RGBeter/MegaDrive_VA6.8/MegaDrive.kicad_pcb

## KiCad design MegaDrive.kicad_pcb (2026-10-28)

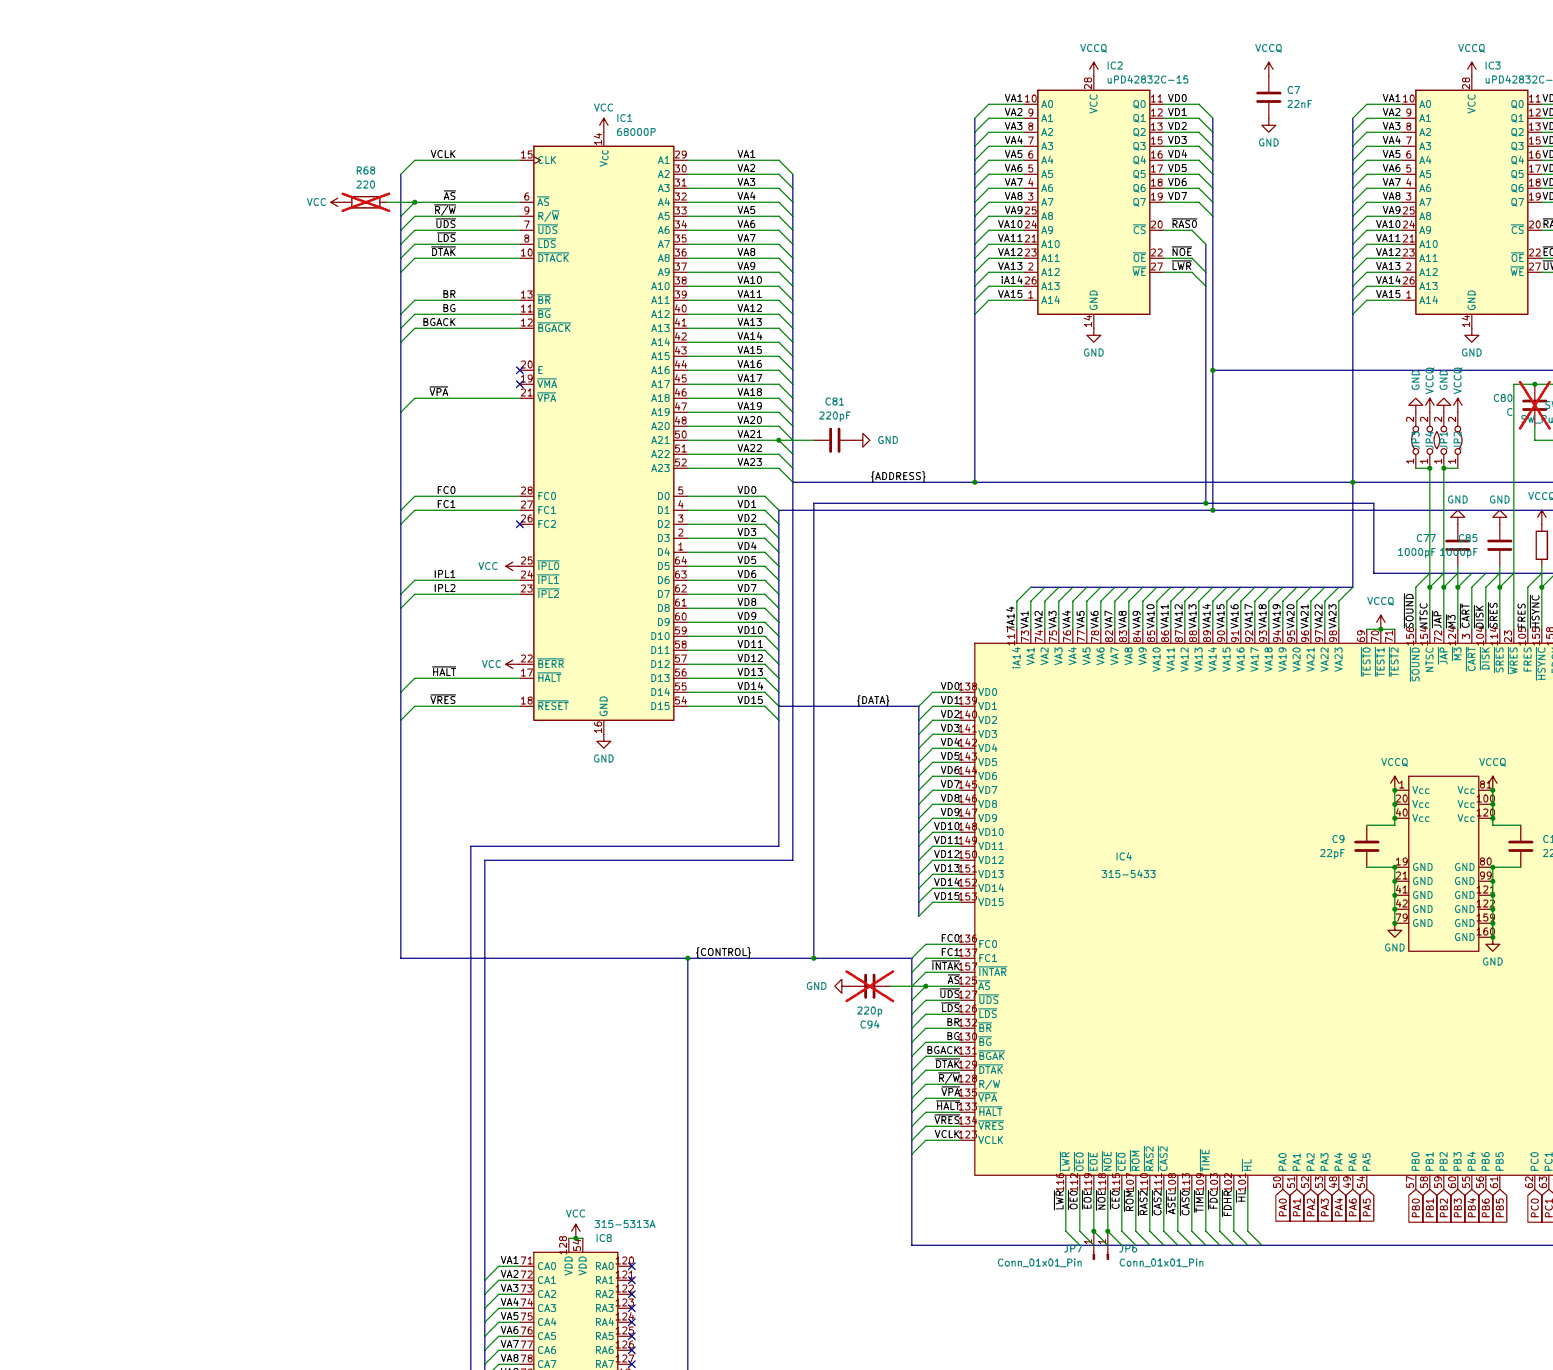
[picture p1: schematic MegaDrive.kicad_sch, part in row 1, column 1]

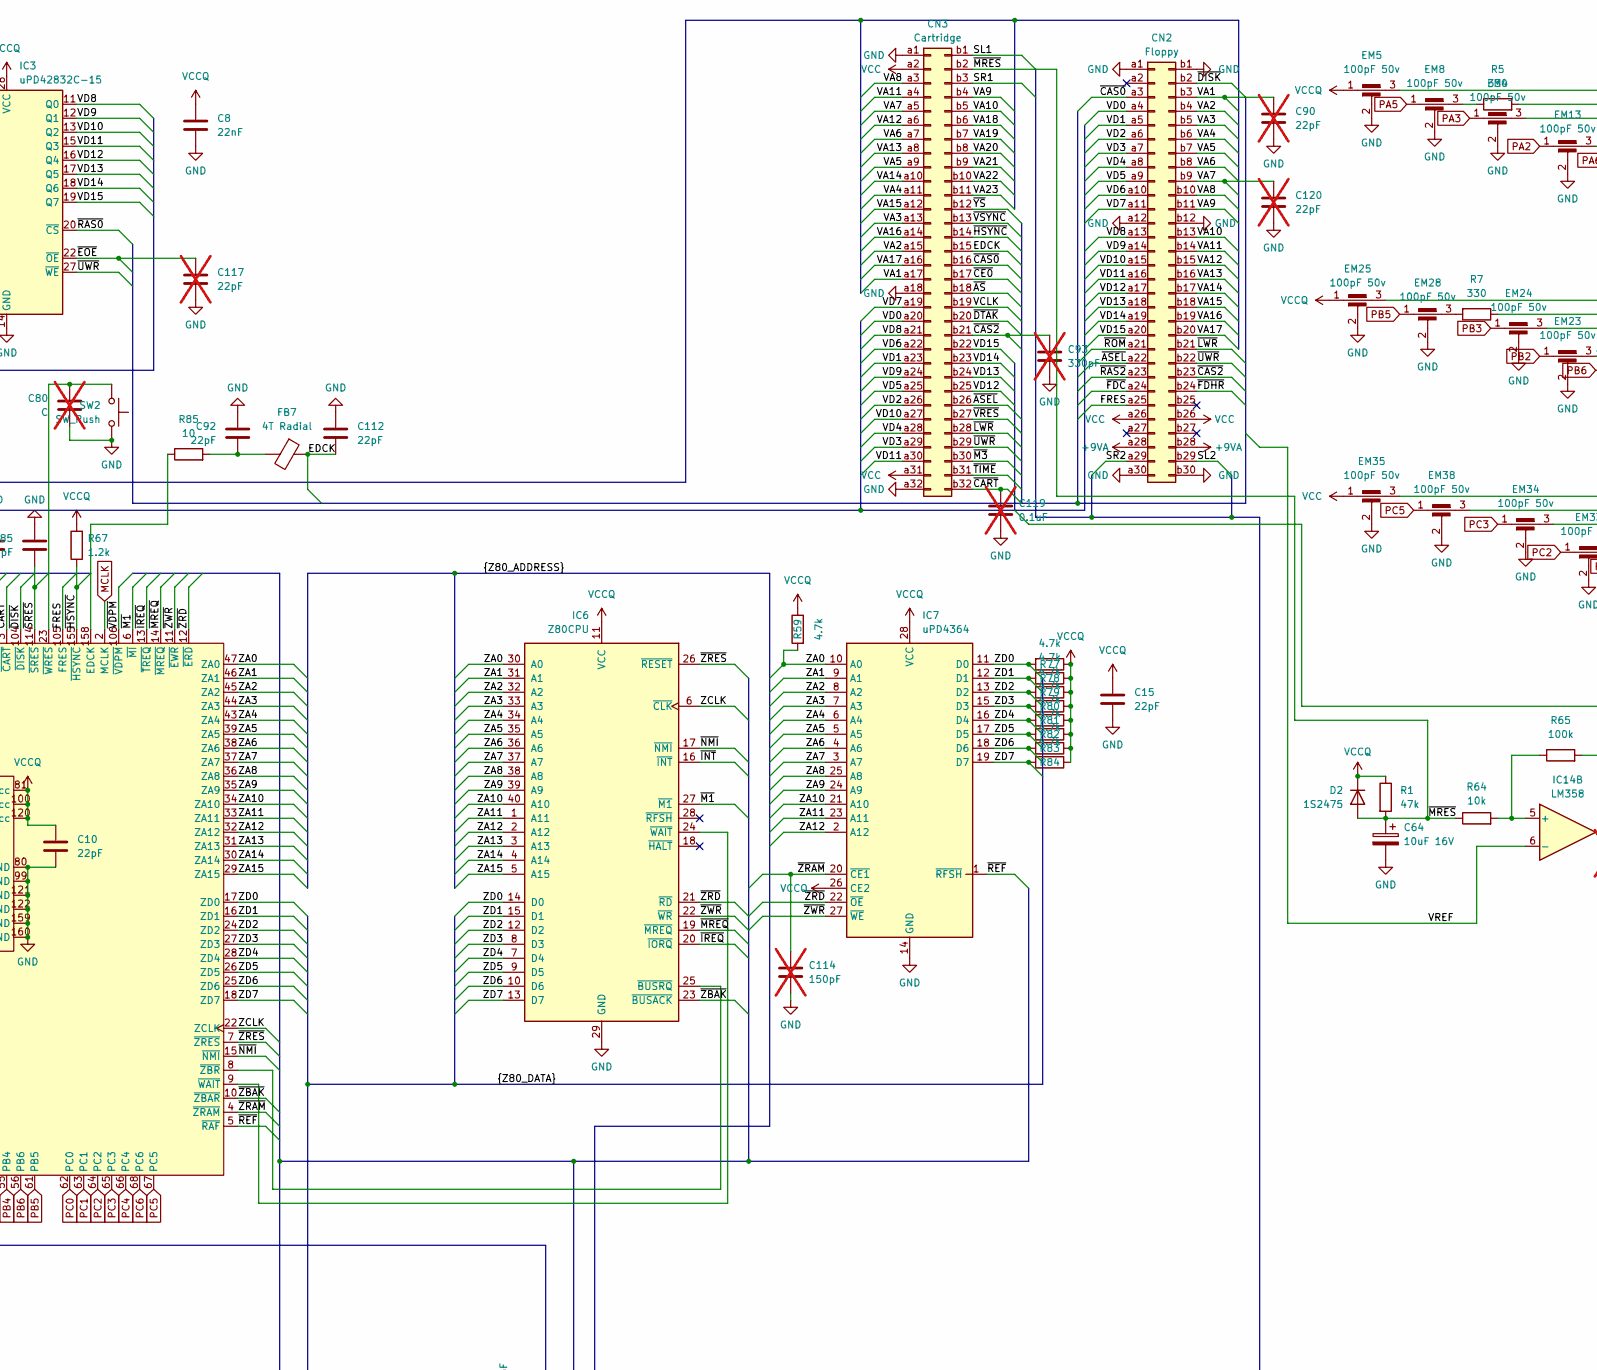
[picture p2: schematic MegaDrive.kicad_sch, part in row 1, column 2]

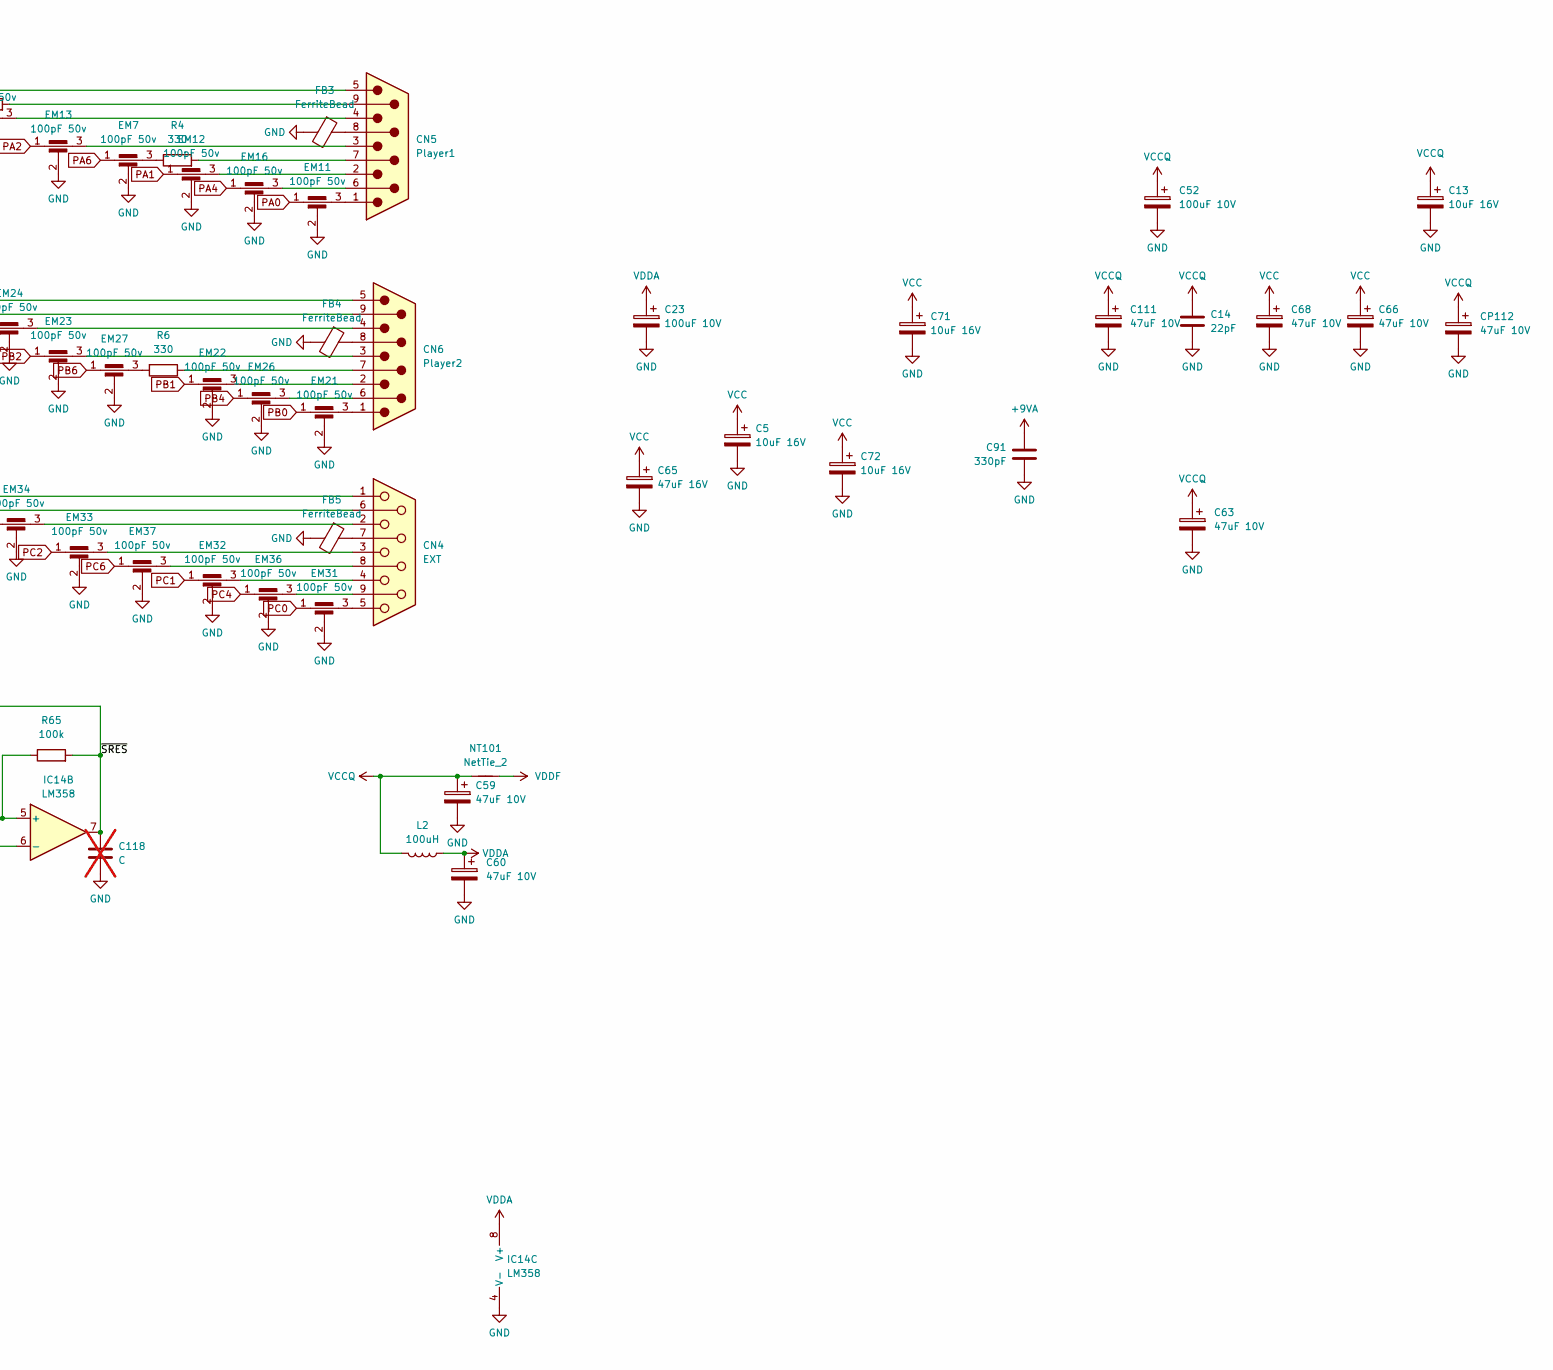
[picture p3: schematic MegaDrive.kicad_sch, part in row 1, column 3]

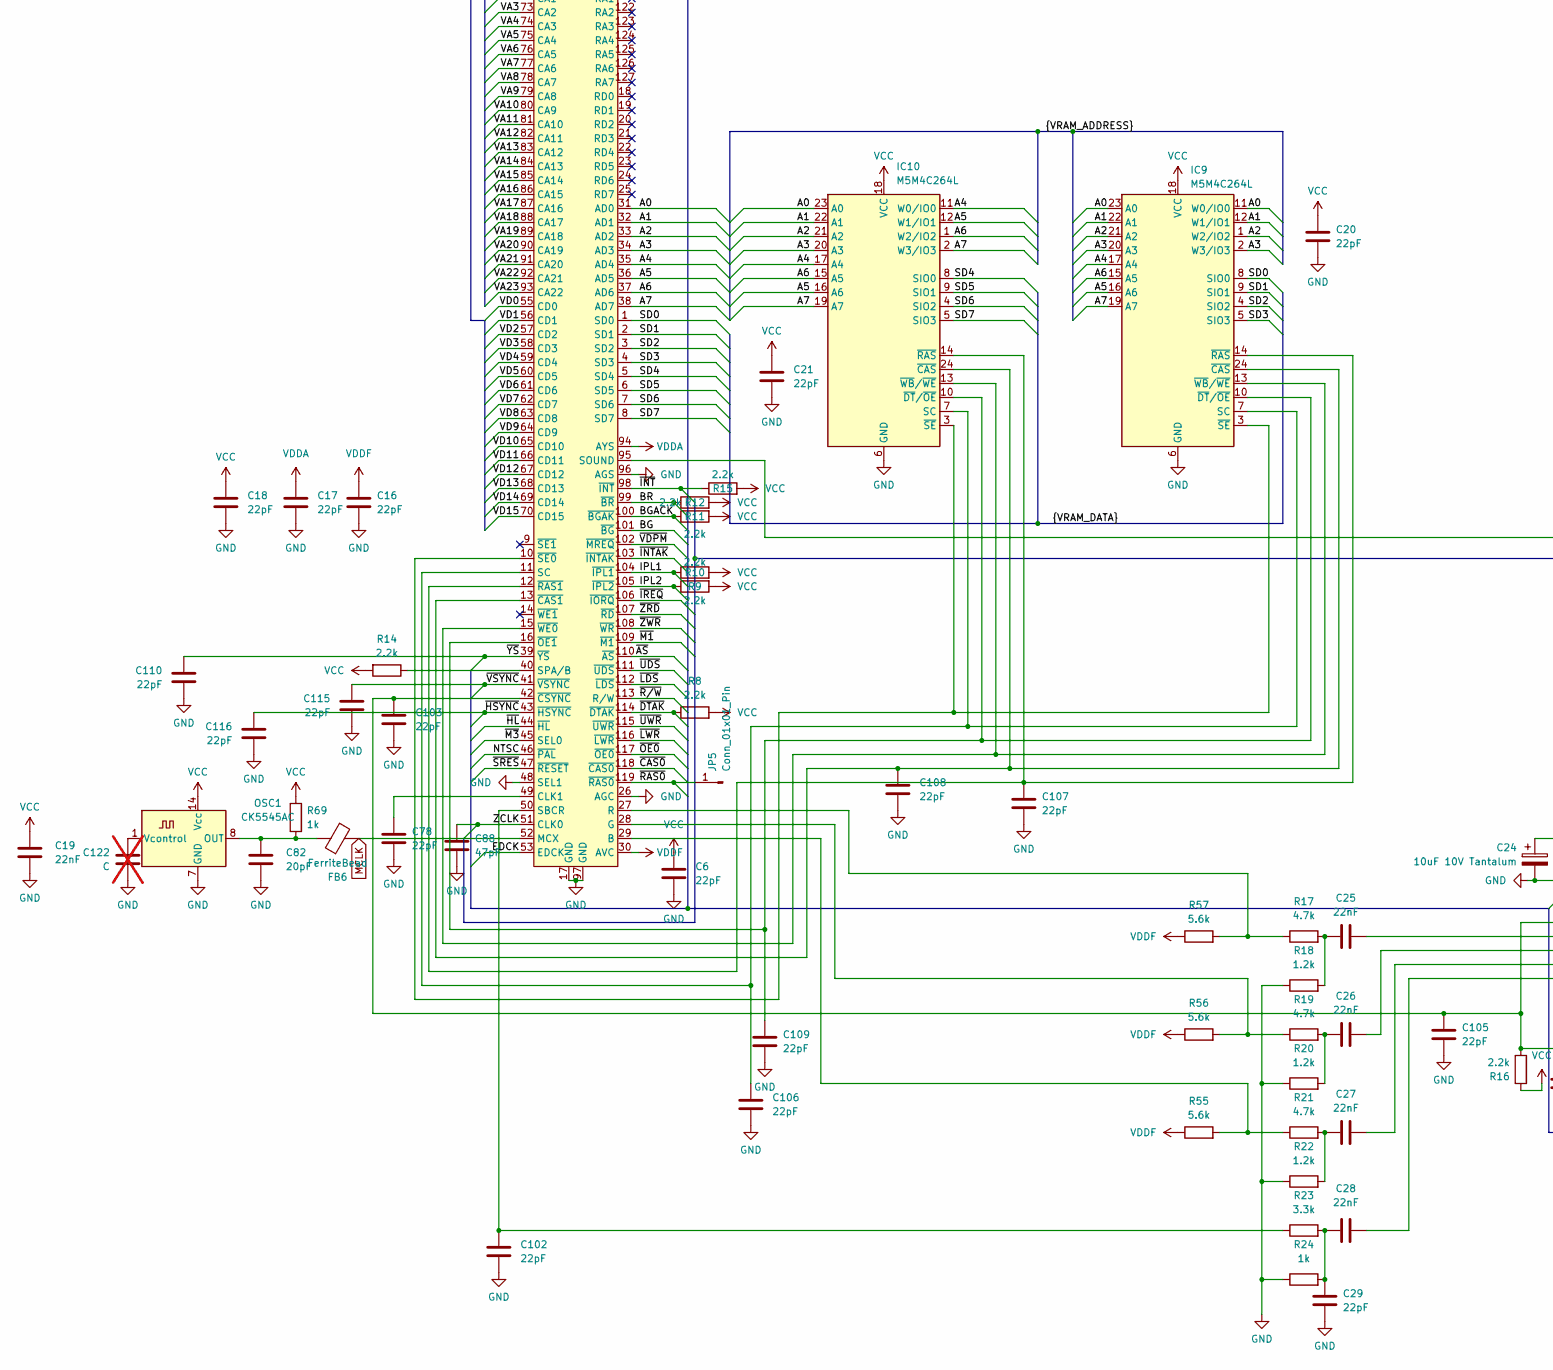
[picture p4: schematic MegaDrive.kicad_sch, part in row 2, column 1]

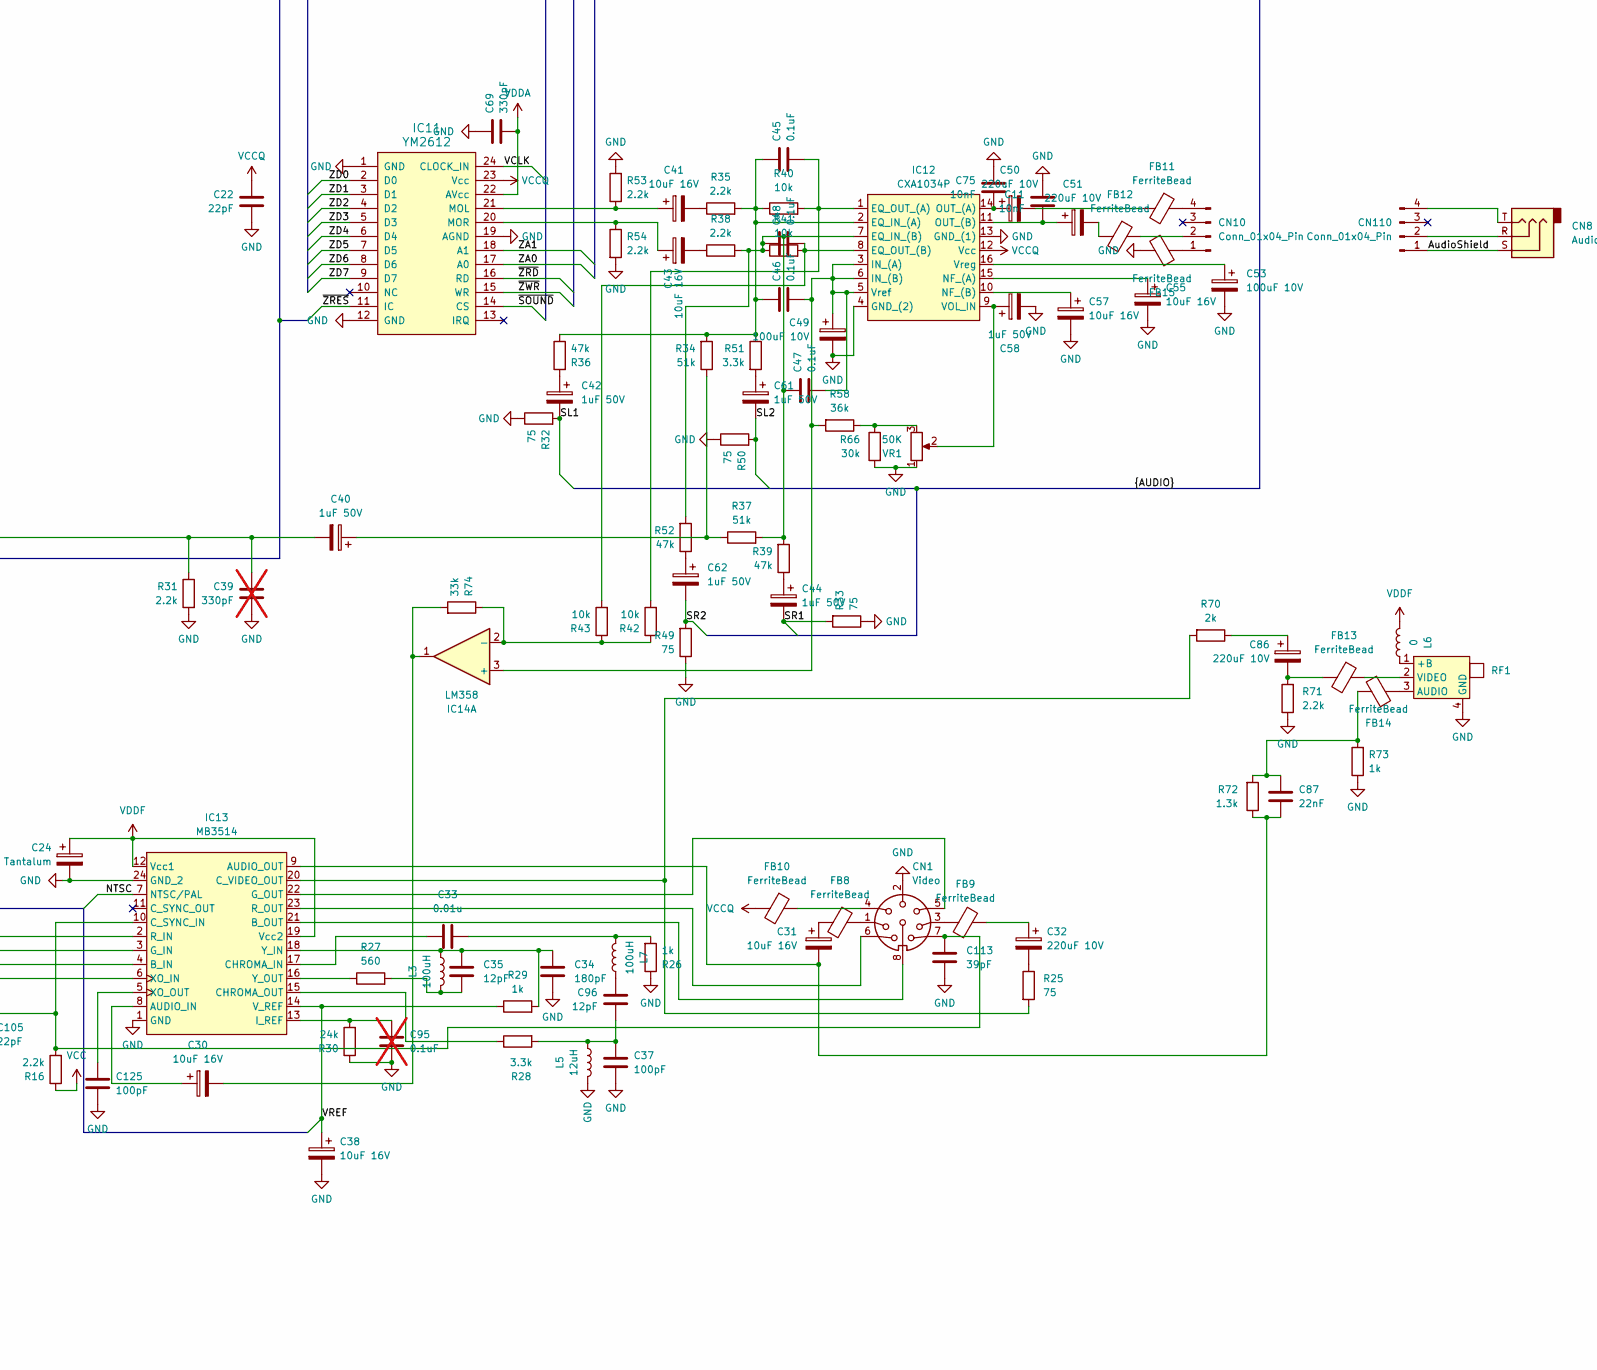
[picture p5: schematic MegaDrive.kicad_sch, part in row 2, column 2]

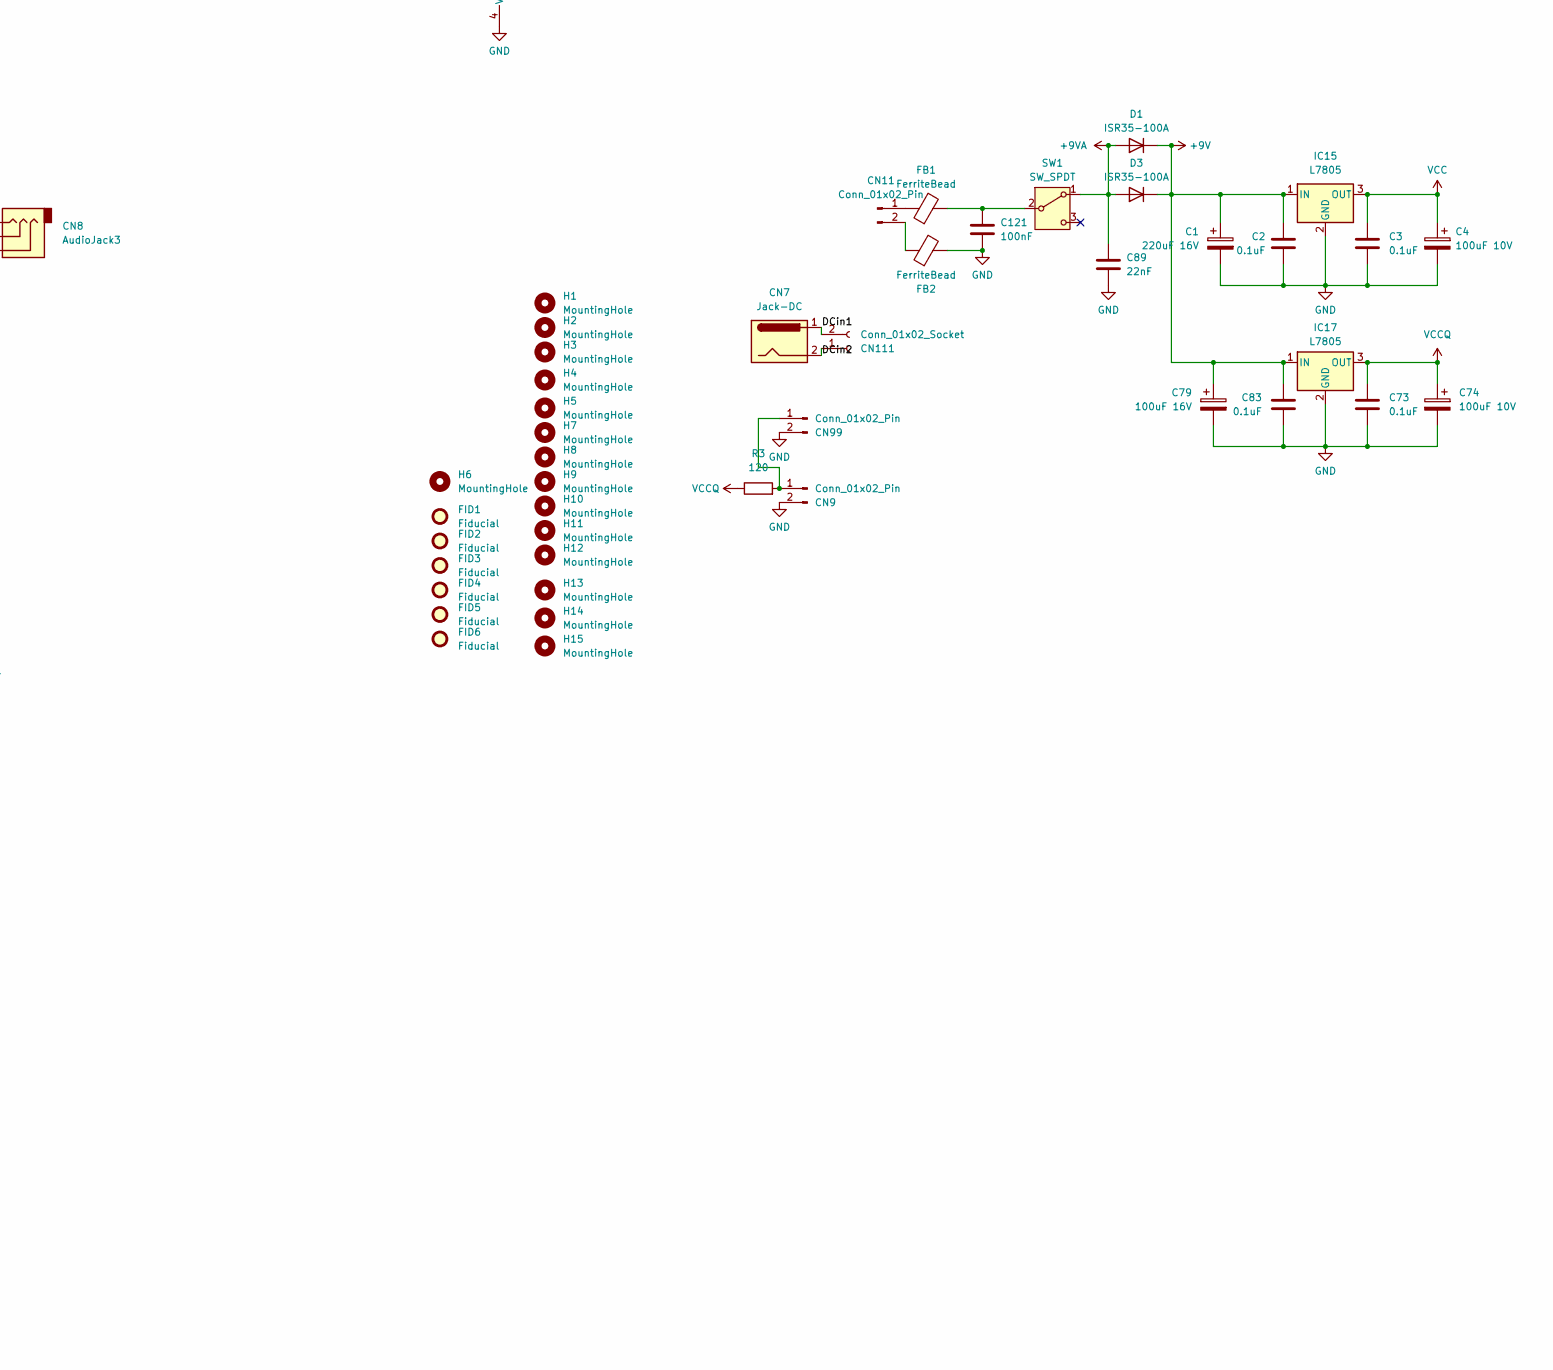
[picture p6: schematic MegaDrive.kicad_sch, part in row 2, column 3]

Parts:
C1: 220uF 16V; CP_Radial_Tantal_D4.5mm_P5.00mm
C2, C3, C45, C46, C47, C48, C73, C83: 0.1uF; C_0805_2012Metric
C4, C23, C49, C52, C53, C74: 100uF 10V; CP_Radial_Tantal_D4.5mm_P5.00mm
C5, C13, C30, C31, C38, C41, C43, C55, C57, C64, C71, C72: 10uF 16V; CP_Radial_Tantal_D4.5mm_P5.00mm
C6, C9, C10, C14, C15, C16, C17, C18, C20, C21, C22, C29, C78, C92, C102, C103, C105, C106, C107, C108, C109, C110, C112, C115, C116: 22pF; C_0805_2012Metric
C7, C8, C19, C25, C26, C27, C28, C87, C89: 22nF; C_0805_2012Metric
C11, C75: 10nF; C_0805_2012Metric
C24: 10uF 10V Tantalum; CP_Radial_Tantal_D4.5mm_P5.00mm
C32, C50, C51, C86: 220uF 10V; CP_Radial_Tantal_D4.5mm_P5.00mm
C33: 0.01u; C_0805_2012Metric
C34: 180pF; C_0805_2012Metric
C35, C96: 12pF; C_0805_2012Metric
C37, C125: 100pF; C_0805_2012Metric
C39, C93: 330pF; C_0805_2012Metric; not fitted
C40, C42, C44, C58, C61, C62: 1uF 50V; CP_Radial_Tantal_D4.5mm_P5.00mm
C59, C60, C63, C66, C68, C111: 47uF 10V; CP_Radial_Tantal_D4.5mm_P5.00mm
C65: 47uF 16V; CP_Radial_Tantal_D4.5mm_P5.00mm
C69, C91: 330pF; C_0805_2012Metric
C77, C85: 1000pF; C_0805_2012Metric
C79: 100uF 16V; CP_Radial_Tantal_D4.5mm_P5.00mm
C80, C118, C122: C; C_0805_2012Metric; not fitted
C81: 220pF; C_0805_2012Metric
C82: 20pF; C_0805_2012Metric
C88: 47pF; C_0805_2012Metric
C90, C117, C120: 22pF; C_0805_2012Metric; not fitted
C94: 220p; C_0805_2012Metric; not fitted
C95, C119: 0.1uF; C_0805_2012Metric; not fitted
C113: 39pF; C_0805_2012Metric
C114: 150pF; C_0805_2012Metric; not fitted
C121: 100nF; C_0805_2012Metric
CN1: Video; DIN8Video
CN2: Floppy; Expansion
CN3: Cartridge; SEGA_2x32_Female_Vertical_THT
CN4: EXT; DSUB-9_Socket_Horizontal_P2.77x2.84mm_EdgePinOffset9.40mm
CN5: Player1; DSUB-9_Pins_Horizontal_P2.77x2.84mm_EdgePinOffset9.40mm
CN6: Player2; DSUB-9_Pins_Horizontal_P2.77x2.84mm_EdgePinOffset9.40mm
CN7: Jack-DC; BarrelJack_CUI_PJ-002A_Horizontal
CN8: AudioJack3; Jack_3.5mm
CN9, CN99: Conn_01x02_Pin; PinSocket_1x02_P2.54mm_Vertical
CN10, CN110: Conn_01x04_Pin; PinHeader_1x04_P2.00mm_Vertical
CN11: Conn_01x02_Pin; PinHeader_1x02_P2.54mm_Vertical
CN111: Conn_01x02_Socket; PinHeader_1x02_P2.54mm_Vertical
CP112: 47uF 10V; CP_Radial_Tantal_D4.5mm_P5.00mm
D1, D3: ISR35-100A; D_A-405_P5.08mm_Vertical_AnodeUp
D2: 1S2475; D_A-405_P5.08mm_Vertical_AnodeUp
EM4, EM5, EM7, EM8, EM11, EM12, EM13, EM16, EM21, EM22, EM23, EM24, EM25, EM26, EM27, EM28, EM31, EM32, EM33, EM34, EM35, EM36, EM37, EM38: 100pF 50v; Resonator-3Pin_W6.0mm_H3.0mm
FB1, FB2, FB3, FB4, FB5, FB8, FB9, FB10, FB13, FB14: FerriteBead; L_Axial_L7.0mm_D3.3mm_P5.08mm_Vertical_Fastron_MICC
FB6, FB11, FB12, FB15: FerriteBead; LairdTech_28C0236-0JW-10
FB7: 4T Radial; LairdTech_28C0236-0JW-10
FID1, FID2, FID3, FID4, FID5, FID6: Fiducial; Fiducial_1.5mm_Mask4.5mm
H1, H2, H3, H4, H5, H7, H8, H9, H10, H11, H12: MountingHole; MountingHole_3.2mm_M3
H6: MountingHole; MountingHole_4mm
H13, H14, H15: MountingHole; MountingHole_5mm
IC1: 68000P; DIP-64_W22.86mm
IC2, IC3: uPD42832C-15; DIP-28_DoubleLast
IC4: 315-5433; QFP-160_28x28_Pitch0.65mm
IC6: Z80CPU; DIP-40_W15.24mm
IC7: uPD4364; DIP-28_DoubleFirst
IC8: 315-5313A; QFP128
IC9, IC10: M5M4C264L; ZIP-24
IC11: YM2612; DIP-24_W15.24mm
IC12: CXA1034P; DIP-16_W7.62mm
IC13: MB3514; SOIC-24_CXA
IC14: LM358; DIP-8_W7.62mm
IC15, IC17: L7805; TO-220-3_Vertical
JP1: JAP; R_Axial_DIN0204_L3.6mm_D1.6mm_P5.08mm_Horizontal
JP2: ENG; R_Axial_DIN0204_L3.6mm_D1.6mm_P5.08mm_Horizontal
JP3: PAL; R_Axial_DIN0204_L3.6mm_D1.6mm_P5.08mm_Horizontal
JP4: NTSC; R_Axial_DIN0204_L3.6mm_D1.6mm_P5.08mm_Horizontal
JP5, JP6, JP7: Conn_01x01_Pin; PinSocket_1x01_P2.54mm_Vertical
L2, L3, L7: 100uH; R_Axial_DIN0204_L3.6mm_D1.6mm_P5.08mm_Horizontal
L5: 12uH; R_Axial_DIN0204_L3.6mm_D1.6mm_P5.08mm_Horizontal
L6: 0; L_Axial_L7.0mm_D3.3mm_P5.08mm_Vertical_Fastron_MICC
NT101: NetTie_2; NetTie-2_SMD_Pad2.0mm
OSC1: CK5545AC; Oscillator_DIP-14
R1, R36, R39, R52: 47k; R_0805_2012Metric
R3: 120; R_0805_2012Metric
R4, R5, R6, R7: 330; R_0805_2012Metric
R8, R9, R10, R11, R12, R14, R15, R16, R31, R35, R38, R53, R54, R71: 2.2k; R_0805_2012Metric
R17, R19, R21, R59, R77, R78, R79, R80, R81, R82, R83, R84: 4.7k; R_0805_2012Metric
R18, R20, R22, R67: 1.2k; R_0805_2012Metric
R23, R28, R51: 3.3k; R_0805_2012Metric
R24, R26, R29, R69, R73: 1k; R_0805_2012Metric
R25, R32, R33, R49, R50: 75; R_0805_2012Metric
R27: 560; R_0805_2012Metric
R30: 24k; R_0805_2012Metric
R34, R37: 51k; R_0805_2012Metric
R40, R41, R42, R43, R64: 10k; R_0805_2012Metric
R55, R56, R57: 5.6k; R_0805_2012Metric
R58: 36k; R_0805_2012Metric
R65: 100k; R_0805_2012Metric
R66: 30k; R_0805_2012Metric
R68: 220; R_0805_2012Metric; not fitted
R70: 2k; R_0805_2012Metric
R72: 1.3k; R_0805_2012Metric
R74: 33k; R_0805_2012Metric
R85: 10; R_0805_2012Metric
RF1: RFmod
SW1: SW_SPDT; SW_E-Switch_EG1224_SPDT_Angled
SW2: SW_Push; SW_Tactile_Straight_KSA0Axx1LFTR
VR1: 50K; HeadphoneVolumeSlider

Connections:
+9V: C1.1, C2.1, C79.1, C83.1, D1.1 (K), D3.1 (K), IC15.1 (IN), IC17.1 (IN)
+9VA: C89.1, C91.1, CN2.a28, CN2.b28, D1.2 (A), D3.2 (A), SW1.1 (A)
/A0: IC8.31 (AD0), IC9.11 (W0/IO0), IC9.23 (A0), IC10.23 (A0)
/A1: IC8.32 (AD1), IC9.12 (W1/IO1), IC9.22 (A1), IC10.22 (A1)
/A2: IC8.33 (AD2), IC9.1 (W2/IO2), IC9.21 (A2), IC10.21 (A2)
/A3: IC8.34 (AD3), IC9.2 (W3/IO3), IC9.20 (A3), IC10.20 (A3)
/A4: IC8.35 (AD4), IC9.17 (A4), IC10.11 (W0/IO0), IC10.17 (A4)
/A5: IC8.36 (AD5), IC9.16 (A6), IC10.12 (W1/IO1), IC10.16 (A6)
/A6: IC8.37 (AD6), IC9.15 (A5), IC10.1 (W2/IO2), IC10.15 (A5)
/A7: IC8.38 (AD7), IC9.19 (A7), IC10.2 (W3/IO3), IC10.19 (A7)
/AudioShield: CN8.S, CN110.1
/BG: IC1.11 (~BG), IC4.130 (~BG), IC8.101 (~BG)
/BGACK: IC1.12 (~BGACK), IC4.131 (~BGAK), IC8.100 (~BGAK), R11.1
/BR: IC1.13 (~BR), IC4.132 (~BR), IC8.99 (~BR), R12.1
/DCin1: CN7.1, CN111.2
/DCin2: CN7.2, CN111.1
/EDCK: C112.2, CN3.b15, FB7.1, IC8.53 (EDCK)
/FC0: IC1.28 (FC0), IC4.136 (FC0)
/FC1: IC1.27 (FC1), IC4.137 (FC1)
/FRES: CN2.a25, IC4.105 (FRES)
/IPL1: IC1.24 (~IPL1), IC8.104 (~IPL1), R10.1
/IPL2: IC1.23 (~IPL2), IC8.105 (~IPL2), R9.1
/NTSC: IC4.154 (NTSC), IC8.46 (~PAL), IC13.7 (NTSC/PAL), JP3.1 (A), JP4.1 (A)
/SD0: IC8.1 (SD0), IC9.8 (SIO0)
/SD1: IC8.2 (SD1), IC9.9 (SIO1)
/SD2: IC8.3 (SD2), IC9.4 (SIO2)
/SD3: IC8.4 (SD3), IC9.5 (SIO3)
/SD4: IC8.5 (SD4), IC10.8 (SIO0)
/SD5: IC8.6 (SD5), IC10.9 (SIO1)
/SD6: IC8.7 (SD6), IC10.4 (SIO2)
/SD7: IC8.8 (SD7), IC10.5 (SIO3)
/SL1: C42.2, CN3.b1, R32.2
/SL2: C61.2, CN2.b29, R50.2
/SR1: C44.2, CN3.b3, R33.2
/SR2: C62.2, CN2.a29, R49.2
/VA1: C90.1, CN2.b3, CN3.a17, IC1.29 (A1), IC2.10 (A0), IC3.10 (A0), IC4.73 (VA1), IC8.71 (CA0)
/VA2: CN2.b4, CN3.a15, IC1.30 (A2), IC2.9 (A1), IC3.9 (A1), IC4.74 (VA2), IC8.72 (CA1)
/VA3: CN2.b5, CN3.a13, IC1.31 (A3), IC2.8 (A2), IC3.8 (A2), IC4.75 (VA3), IC8.73 (CA2)
/VA4: CN2.b6, CN3.a11, IC1.32 (A4), IC2.7 (A3), IC3.7 (A3), IC4.76 (VA4), IC8.74 (CA3)
/VA5: CN2.b7, CN3.a9, IC1.33 (A5), IC2.6 (A4), IC3.6 (A4), IC4.77 (VA5), IC8.75 (CA4)
/VA6: CN2.b8, CN3.a7, IC1.34 (A6), IC2.5 (A5), IC3.5 (A5), IC4.78 (VA6), IC8.76 (CA5)
/VA7: C120.1, CN2.b9, CN3.a5, IC1.35 (A7), IC2.4 (A6), IC3.4 (A6), IC4.82 (VA7), IC8.77 (CA6)
/VA8: CN2.b10, CN3.a3, IC1.36 (A8), IC2.3 (A7), IC3.3 (A7), IC4.83 (VA8), IC8.78 (CA7)
/VA9: CN2.b11, CN3.b4, IC1.37 (A9), IC2.25 (A8), IC3.25 (A8), IC4.84 (VA9), IC8.79 (CA8)
/VA10: CN2.b13, CN3.b5, IC1.38 (A10), IC2.24 (A9), IC3.24 (A9), IC4.85 (VA10), IC8.80 (CA9)
/VA11: CN2.b14, CN3.a4, IC1.39 (A11), IC2.21 (A10), IC3.21 (A10), IC4.86 (VA11), IC8.81 (CA10)
/VA12: CN2.b15, CN3.a6, IC1.40 (A12), IC2.23 (A11), IC3.23 (A11), IC4.87 (VA12), IC8.82 (CA11)
/VA13: CN2.b16, CN3.a8, IC1.41 (A13), IC2.2 (A12), IC3.2 (A12), IC4.88 (VA13), IC8.83 (CA12)
/VA14: CN2.b17, CN3.a10, IC1.42 (A14), IC3.26 (A13), IC4.89 (VA14), IC8.84 (CA13)
/VA15: CN2.b18, CN3.a12, IC1.43 (A15), IC2.1 (A14), IC3.1 (A14), IC4.90 (VA15), IC8.85 (CA14)
/VA16: CN2.b19, CN3.a14, IC1.44 (A16), IC4.91 (VA16), IC8.86 (CA15)
/VA17: CN2.b20, CN3.a16, IC1.45 (A17), IC4.92 (VA17), IC8.87 (CA16)
/VA18: CN3.b6, IC1.46 (A18), IC4.93 (VA18), IC8.88 (CA17)
/VA19: CN3.b7, IC1.47 (A19), IC4.94 (VA19), IC8.89 (CA18)
/VA20: CN3.b8, IC1.48 (A20), IC4.95 (VA20), IC8.90 (CA19)
/VA21: C81.2, CN3.b9, IC1.50 (A21), IC4.96 (VA21), IC8.91 (CA20)
/VA22: CN3.b10, IC1.51 (A22), IC4.97 (VA22), IC8.92 (CA21)
/VA23: CN3.b11, IC1.52 (A23), IC4.98 (VA23), IC8.93 (CA22)
/VCLK: CN3.b19, IC1.15 (CLK), IC4.123 (VCLK), IC11.24 (CLOCK_IN)
/VD0: CN2.a4, CN3.a20, IC1.5 (D0), IC2.11 (Q0), IC4.138 (VD0), IC8.55 (CD0)
/VD1: CN2.a5, CN3.a23, IC1.4 (D1), IC2.12 (Q1), IC4.139 (VD1), IC8.56 (CD1)
/VD2: CN2.a6, CN3.a26, IC1.3 (D2), IC2.13 (Q2), IC4.140 (VD2), IC8.57 (CD2)
/VD3: CN2.a7, CN3.a29, IC1.2 (D3), IC2.15 (Q3), IC4.141 (VD3), IC8.58 (CD3)
/VD4: CN2.a8, CN3.a28, IC1.1 (D4), IC2.16 (Q4), IC4.142 (VD4), IC8.59 (CD4)
/VD5: CN2.a9, CN3.a25, IC1.64 (D5), IC2.17 (Q5), IC4.143 (VD5), IC8.60 (CD5)
/VD6: CN2.a10, CN3.a22, IC1.63 (D6), IC2.18 (Q6), IC4.144 (VD6), IC8.61 (CD6)
/VD7: CN2.a11, CN3.a19, IC1.62 (D7), IC2.19 (Q7), IC4.145 (VD7), IC8.62 (CD7)
/VD8: CN2.a13, CN3.a21, IC1.61 (D8), IC3.11 (Q0), IC4.146 (VD8), IC8.63 (CD8)
/VD9: CN2.a14, CN3.a24, IC1.60 (D9), IC3.12 (Q1), IC4.147 (VD9), IC8.64 (CD9)
/VD10: CN2.a15, CN3.a27, IC1.59 (D10), IC3.13 (Q2), IC4.148 (VD10), IC8.65 (CD10)
/VD11: CN2.a16, CN3.a30, IC1.58 (D11), IC3.15 (Q3), IC4.149 (VD11), IC8.66 (CD11)
/VD12: CN2.a17, CN3.b25, IC1.57 (D12), IC3.16 (Q4), IC4.150 (VD12), IC8.67 (CD12)
/VD13: CN2.a18, CN3.b24, IC1.56 (D13), IC3.17 (Q5), IC4.151 (VD13), IC8.68 (CD13)
/VD14: CN2.a19, CN3.b23, IC1.55 (D14), IC3.18 (Q6), IC4.152 (VD14), IC8.69 (CD14)
/VD15: CN2.a20, CN3.b22, IC1.54 (D15), IC3.19 (Q7), IC4.153 (VD15), IC8.70 (CD15)
/VREF: C38.1, IC13.14 (V_REF), IC14.6 (-), R29.1
/ZA0: IC4.47 (ZA0), IC6.30 (A0), IC7.10 (A0), IC11.17 (A0), R59.2
/ZA1: IC4.46 (ZA1), IC6.31 (A1), IC7.9 (A1), IC11.18 (A1)
/ZA2: IC4.45 (ZA2), IC6.32 (A2), IC7.8 (A2)
/ZA3: IC4.44 (ZA3), IC6.33 (A3), IC7.7 (A3)
/ZA4: IC4.43 (ZA4), IC6.34 (A4), IC7.6 (A4)
/ZA5: IC4.39 (ZA5), IC6.35 (A5), IC7.5 (A5)
/ZA6: IC4.38 (ZA6), IC6.36 (A6), IC7.4 (A6)
/ZA7: IC4.37 (ZA7), IC6.37 (A7), IC7.3 (A7)
/ZA8: IC4.36 (ZA8), IC6.38 (A8), IC7.25 (A8)
/ZA9: IC4.35 (ZA9), IC6.39 (A9), IC7.24 (A9)
/ZA10: IC4.34 (ZA10), IC6.40 (A10), IC7.21 (A10)
/ZA11: IC4.33 (ZA11), IC6.1 (A11), IC7.23 (A11)
/ZA12: IC4.32 (ZA12), IC6.2 (A12), IC7.2 (A12)
/ZA13: IC4.31 (ZA13), IC6.3 (A13)
/ZA14: IC4.30 (ZA14), IC6.4 (A14)
/ZA15: IC4.29 (ZA15), IC6.5 (A15)
/ZCLK: C88.1, IC4.22 (ZCLK), IC6.6 (~CLK), IC8.51 (CLK0)
/ZD0: IC4.17 (ZD0), IC6.14 (D0), IC7.11 (D0), IC11.2 (D0), R77.2
/ZD1: IC4.16 (ZD1), IC6.15 (D1), IC7.12 (D1), IC11.3 (D1), R78.2
/ZD2: IC4.24 (ZD2), IC6.12 (D2), IC7.13 (D2), IC11.4 (D2), R79.2
/ZD3: IC4.27 (ZD3), IC6.8 (D3), IC7.15 (D3), IC11.5 (D3), R80.2
/ZD4: IC4.28 (ZD4), IC6.7 (D4), IC7.16 (D4), IC11.6 (D4), R81.2
/ZD5: IC4.26 (ZD5), IC6.9 (D5), IC7.17 (D5), IC11.7 (D5), R82.2
/ZD6: IC4.25 (ZD6), IC6.10 (D6), IC7.18 (D6), IC11.8 (D6), R83.2
/ZD7: IC4.18 (ZD7), IC6.13 (D7), IC7.19 (D7), IC11.9 (D7), R84.2
/iA14: IC2.26 (A13), IC4.117 (iA14)
/~ASEL: CN2.a22, CN3.b26, IC4.108
/~AS: C94.2, CN3.b18, IC1.6 (~AS), IC4.125 (~AS), IC8.110 (~AS), R68.1
/~CART: C119.1, CN3.b32, IC4.3 (~CART)
/~CAS0: CN2.a3, CN3.b16, IC4.113, IC8.118 (~CAS0)
/~CAS2: C93.1, CN2.b23, CN3.b21, IC4.111 (~CAS2)
/~CE0: CN3.b17, IC4.115 (~CE0)
/~DISK: CN2.b2, IC4.104 (~DISK)
/~DTAK: CN3.b20, IC1.10 (~DTACK), IC4.129 (~DTAK), IC8.114 (~DTAK), R8.1
/~EOE: C117.1, IC3.22 (~OE), IC4.119 (~EOE), JP7.1
/~FDC: CN2.a24, IC4.103
/~FDHR: CN2.b24, IC4.102
/~HALT: IC1.17 (~HALT), IC4.133 (~HALT)
/~HL: IC4.101 (~HL), IC8.44 (~HL)
/~HSYNC: C116.1, CN3.b14, IC4.155 (~HSYNC), IC8.43 (~HSYNC), R67.1
/~INTAK: IC4.157 (~INTAR), IC8.103 (~INTAK)
/~INT: IC6.16 (~INT), IC8.98 (~INT), R15.1
/~IREQ: IC4.13 (~TREQ), IC6.20 (~IORQ), IC8.106 (~IORQ)
/~JAP: IC4.72 (~JAP), JP1.1 (A), JP2.1 (A)
/~LDS: IC1.8 (~LDS), IC4.126 (~LDS), IC8.112 (~LDS)
/~LWR: CN2.b21, CN3.b28, IC2.27 (~WE), IC4.116 (~LWR), IC8.116 (~LWR)
/~M1: IC4.6 (~MI), IC6.27 (~M1), IC8.109 (~M1)
/~M3: C77.2, CN3.b30, IC4.124 (~M3), IC8.45 (SEL0)
/~MREQ: IC4.14 (~MREQ), IC6.19 (~MREQ)
/~MRES: C64.1, CN3.b2, D2.2 (A), R1.2, R64.1
/~NMI: IC4.15 (~NMI), IC6.17 (~NMI)
/~NOE: IC2.22 (~OE), IC4.118 (~NOE), JP6.1
/~OE0: IC4.112 (~OE0), IC8.117 (~OE0)
/~RAS0: IC2.20 (~CS), IC3.20 (~CS), IC8.119 (~RAS0), JP5.1
/~RAS2: CN2.a23, IC4.110 (~RAS2)
/~REF: IC4.5 (~RAF), IC7.1 (~RFSH)
/~ROM: CN2.a21, IC4.107 (~ROM)
/~R/W: IC1.9 (R/~W), IC4.128 (R/W), IC8.113 (R/W)
/~SOUND: IC4.156 (~SOUND), IC11.14 (CS)
/~SRES: C85.2, C118.1, IC4.114 (~SRES), IC8.47 (~RESET), IC14.7, R65.2
/~TIME: CN3.b31, IC4.109 (~TIME)
/~UDS: IC1.7 (~UDS), IC4.127 (~UDS), IC8.111 (~UDS)
/~UWR: CN2.b22, CN3.b29, IC3.27 (~WE), IC8.115 (~UWR)
/~VDPM: IC4.106 (~VDPM), IC8.102 (~MREQ)
/~VPA: IC1.21 (~VPA), IC4.135 (~VPA)
/~VRES: CN3.b27, IC1.18 (~RESET), IC4.134 (~VRES)
/~VSYNC: C115.1, CN3.b13, IC8.41 (~VSYNC)
/~YS: C110.1, CN3.b12, IC8.39 (~YS)
/~ZBAK: IC4.10 (~ZBAR), IC6.23 (~BUSACK)
/~ZRAM: C114.1, IC4.4 (~ZRAM), IC7.20 (~CE1)
/~ZRD: IC4.12 (~ERD), IC6.21 (~RD), IC7.22 (~OE), IC8.107 (~RD), IC11.16 (RD)
/~ZRES: IC4.7 (~ZRES), IC6.26 (~RESET), IC11.11 (IC)
/~ZWR: IC4.11 (~EWR), IC6.22 (~WR), IC7.27 (~WE), IC8.108 (~WR), IC11.15 (WR)
GND: C1.2, C2.2, C3.2, C4.2, C5.2, C6.2, C7.2, C8.2, C9.2, C10.2, C11.2, C13.2, C14.2, C15.2, C16.2, C17.2, C18.2, C19.2, C20.2, C21.2, C22.2, C23.2, C24.2, C29.2, C34.2, C37.2, C38.2, C39.2, C49.2, C52.2, C53.2, C55.2, C57.2, C58.2, C59.2, C60.2, C63.2, C64.2, C65.2, C66.2, C68.2, C69.1, C71.2, C72.2, C73.2, C74.2, C75.2, C77.1, C78.2, C79.2, C80.2, C81.1, C82.2, C83.2, C85.1, C88.2, C89.2, C90.2, C91.2, C92.1, C93.2, C94.1, C95.2, C102.2, C103.2, C105.2, C106.2, C107.2, C108.2, C109.2, C110.2, C111.2, C112.1, C113.2, C114.2, C115.2, C116.2, C117.2, C118.2, C119.2, C120.2, C121.2, C122.2, C125.2, CN1.2, CN2.a1, CN2.a12, CN2.a30, CN2.b1, CN2.b12, CN2.b30, CN3.a1, CN3.a18, CN3.a32, CN9.2, CN99.2, CP112.2, EM4.2, EM5.2, EM7.2, EM8.2, EM11.2, EM12.2, EM13.2, EM16.2, EM21.2, EM22.2, EM23.2, EM24.2, EM25.2, EM26.2, EM27.2, EM28.2, EM31.2, EM32.2, EM33.2, EM34.2, EM35.2, EM36.2, EM37.2, EM38.2, FB2.2, FB3.2, FB4.2, FB5.2, FB15.2, IC1.16 (GND), IC1.53 (GND), IC2.14 (GND), IC3.14 (GND), IC4.19 (GND), IC4.21 (GND), IC4.41 (GND), IC4.42 (GND), IC4.79 (GND), IC4.80 (GND), IC4.99 (GND), IC4.121 (GND), IC4.122 (GND), IC4.159 (GND), IC4.160 (GND), IC6.29 (GND), IC7.14 (GND), IC8.17 (GND), IC8.26 (AGC), IC8.48 (SEL1), IC8.96 (AGS), IC8.97 (GND), IC9.6 (GND), IC10.6 (GND), IC11.1 (GND), IC11.12 (GND), IC11.19 (AGND), IC12.4 (GND_(2)), IC12.13 (GND_(1)), IC13.1 (GND), IC13.24 (GND_2), IC14.4 (V-), IC15.2 (GND), IC17.2 (GND), JP1.2 (B), JP3.2 (B), L5.1, OSC1.7 (GND), R18.1, R20.1, R22.1, R24.1, R26.1, R30.1, R31.2, R32.1, R33.1, R49.1, R50.1, R53.2, R54.2, R66.2, R71.1, R73.1, RF1.4 (GND), SW2.1, VR1.1
MCLK: FB6.2, IC4.2 (MCLK), IC8.52 (MCX)
unnamed: C25.1, R17.2, R18.2
unnamed: C26.1, R19.2, R20.2
unnamed: C27.1, R21.2, R22.2
unnamed: C28.2, C29.1, R23.2, R24.2
unnamed: C30.2, IC14.1, R74.2
unnamed: C31.1, FB8.2
unnamed: C32.1, FB9.2
unnamed: C32.2, R25.1
unnamed: C33.2, L7.2, R26.2
unnamed: C35.2, L3.1, R27.2
unnamed: C37.1, C96.2, L5.2, R28.2
unnamed: C40.1, R34.1, R37.1
unnamed: C41.2, R35.1
unnamed: C42.1, R36.2
unnamed: C43.2, R38.1
unnamed: C44.1, R39.1
unnamed: C50.2, FB11.2
unnamed: C51.2, FB12.2
unnamed: C61.1, R51.2
unnamed: C62.1, R52.1
unnamed: C86.1, R70.1
unnamed: C86.2, FB13.2, R71.2
unnamed: C87.1, FB14.1, R72.2, R73.2
unnamed: C92.2, FB7.2, R85.2
unnamed: C96.1, L7.1
unnamed: CN1.1, FB8.1
unnamed: CN1.3, FB9.1
unnamed: CN1.4, FB10.1
unnamed: CN4.1, EM35.3
unnamed: CN4.2, EM34.3
unnamed: CN4.3, EM33.3
unnamed: CN4.4, EM32.3
unnamed: CN4.5, EM31.3
unnamed: CN4.6, EM38.3
unnamed: CN4.7, FB5.1
unnamed: CN4.8, EM37.3
unnamed: CN4.9, EM36.3
unnamed: CN5.1, EM11.3
unnamed: CN5.2, EM12.3
unnamed: CN5.3, EM13.3
unnamed: CN5.4, EM4.3
unnamed: CN5.5, EM5.3
unnamed: CN5.6, EM16.3
unnamed: CN5.7, R4.2
unnamed: CN5.8, FB3.1
unnamed: CN5.9, R5.2
unnamed: CN6.1, EM21.3
unnamed: CN6.2, EM22.3
unnamed: CN6.3, EM23.3
unnamed: CN6.4, EM24.3
unnamed: CN6.5, EM25.3
unnamed: CN6.6, EM26.3
unnamed: CN6.7, R6.1
unnamed: CN6.8, FB4.1
unnamed: CN6.9, R7.1
unnamed: CN9.1, CN99.1, R3.2
unnamed: CN10.1, FB15.1
unnamed: CN10.2, FB12.1
unnamed: CN10.4, FB11.1
unnamed: CN11.1, FB1.1
unnamed: CN11.2, FB2.1
unnamed: CN8.R, CN110.2
unnamed: CN8.T, CN110.4
unnamed: EM7.3, R4.1
unnamed: EM8.3, R5.1
unnamed: EM27.3, R6.2
unnamed: EM28.3, R7.2
unnamed: IC4.158 (EDCK), R85.1
unnamed: IC4.9 (~WAIT), IC6.24 (~WAIT)
unnamed: C80.1, IC4.23 (~WRES), SW2.2
unnamed: IC4.8 (~ZBR), IC6.25 (~BUSRQ)
unnamed: IC8.29 (B), R21.1, R55.2
unnamed: C78.1, IC8.49 (CLK1)
unnamed: IC8.28 (G), R19.1, R56.2
unnamed: IC8.27 (R), R17.1, R57.2
unnamed: C102.1, IC8.50 (SBCR), R23.1
unnamed: C39.1, C40.2, IC8.95 (SOUND), R31.1
unnamed: IC8.40 (SPA/B), R14.1
unnamed: C106.1, IC8.11 (SC), IC9.7 (SC), IC10.7 (SC)
unnamed: C108.1, IC8.13 (~CAS1), IC9.24 (~CAS), IC10.24 (~CAS)
unnamed: C109.1, IC8.16 (~OE1), IC9.10 (~DT/~OE), IC10.10 (~DT/~OE)
unnamed: C107.1, IC8.12 (~RAS1), IC9.14 (~RAS), IC10.14 (~RAS)
unnamed: IC8.10 (~SE0), IC9.3 (~SE), IC10.3 (~SE)
unnamed: IC8.15 (~WE0), IC9.13 (~WB/~WE), IC10.13 (~WB/~WE)
unnamed: C41.1, IC11.21 (MOL), R53.1
unnamed: C43.1, IC11.20 (MOR), R54.1
unnamed: C45.1, C46.1, IC12.2 (EQ_IN_(A)), R34.2, R35.2, R36.1, R40.1, R51.1
unnamed: C47.1, C48.1, IC12.7 (EQ_IN_(B)), R37.2, R38.2, R39.2, R41.1, R52.2
unnamed: C45.2, IC12.1 (EQ_OUT_(A)), R40.2, R42.2
unnamed: C48.2, IC12.8 (EQ_OUT_(B)), R41.2, R43.2
unnamed: C46.2, C47.2, C49.1, IC12.3 (IN_(A)), IC12.5 (Vref), IC12.6 (IN_(B)), IC14.3 (+), R58.2
unnamed: C55.1, IC12.15 (NF_(A))
unnamed: C57.1, IC12.10 (NF_(B))
unnamed: C50.1, C75.1, IC12.14 (OUT_(A))
unnamed: C11.1, C51.1, IC12.11 (OUT_(B))
unnamed: C58.1, IC12.9 (VOL_IN), VR1.2
unnamed: C53.1, IC12.16 (Vreg)
unnamed: C30.1, IC13.8 (AUDIO_IN)
unnamed: C31.2, C87.2, IC13.9 (AUDIO_OUT), R72.1
unnamed: C27.2, IC13.4 (B_IN)
unnamed: CN1.8, IC13.21 (B_OUT)
unnamed: C33.1, IC13.17 (CHROMA_IN)
unnamed: IC13.15 (CHROMA_OUT), R28.1
unnamed: C103.1, C105.1, C113.1, CN1.7, IC8.42 (~CSYNC), IC13.10 (C_SYNC_IN), R16.2
unnamed: IC13.20 (C_VIDEO_OUT), R25.2, R70.2
unnamed: C26.2, IC13.3 (G_IN)
unnamed: CN1.5, IC13.22 (G_OUT)
unnamed: C95.1, IC13.13 (I_REF), R30.2
unnamed: C25.2, IC13.2 (R_IN)
unnamed: CN1.6, IC13.23 (R_OUT)
unnamed: C28.1, IC13.6 (XO_IN)
unnamed: C125.1, IC13.5 (XO_OUT)
unnamed: C34.1, C35.1, IC13.18 (Y_IN), L3.2, R29.2
unnamed: IC13.16 (Y_OUT), R27.1
unnamed: IC14.2 (-), R42.1, R43.1, R74.1
unnamed: IC14.5 (+), R64.2, R65.1
unnamed: C82.1, FB6.1, OSC1.8 (OUT), R69.1
unnamed: C122.1, OSC1.1 (Vcontrol)
unnamed: R58.1, R66.1, VR1.3
unnamed: L6.2, RF1.1 (+B)
unnamed: FB14.2, RF1.3 (AUDIO)
unnamed: FB13.1, RF1.2 (VIDEO)
unnamed: C121.1, FB1.2, SW1.2 (B)
PA0: EM11.1, IC4.50 (PA0)
PA1: EM12.1, IC4.51 (PA1)
PA2: EM13.1, IC4.52 (PA2)
PA3: EM4.1, IC4.53 (PA3)
PA4: EM16.1, IC4.48 (PA4)
PA5: EM8.1, IC4.54 (PA5)
PA6: EM7.1, IC4.49 (PA6)
PB0: EM21.1, IC4.57 (PB0)
PB1: EM22.1, IC4.58 (PB1)
PB2: EM23.1, IC4.59 (PB2)
PB3: EM24.1, IC4.60 (PB3)
PB4: EM26.1, IC4.55 (PB4)
PB5: EM28.1, IC4.61 (PB5)
PB6: EM27.1, IC4.56 (PB6)
PC0: EM31.1, IC4.62 (PC0)
PC1: EM32.1, IC4.63 (PC1)
PC2: EM33.1, IC4.64 (PC2)
PC3: EM34.1, IC4.65 (PC3)
PC4: EM36.1, IC4.66 (PC4)
PC5: EM38.1, IC4.67 (PC5)
PC6: EM37.1, IC4.68 (PC6)
VCC: C3.1, C4.1, C5.1, C6.1, C18.1, C19.1, C20.1, C21.1, C65.1, C66.1, C68.1, C71.1, C72.1, CN2.a26, CN2.b26, CN3.a2, CN3.a31, EM35.1, IC1.14 (V_{CC}), IC1.22 (~BERR), IC1.25 (~IPL0), IC1.49 (V_{CC}), IC8.54 (VDD), IC8.128 (VDD), IC9.18 (VCC), IC10.18 (VCC), IC15.3 (OUT), OSC1.14 (Vcc), R8.2, R9.2, R10.2, R11.2, R12.2, R14.2, R15.2, R16.1, R68.2, R69.2
VCCQ: C7.1, C8.1, C9.1, C10.1, C13.1, C14.1, C15.1, C22.1, C52.1, C59.1, C63.1, C73.1, C74.1, C111.1, CP112.1, D2.1 (K), EM5.1, EM25.1, FB10.2, IC2.28 (VCC), IC3.28 (VCC), IC4.1 (Vcc), IC4.20 (Vcc), IC4.40 (Vcc), IC4.69 (~TEST0), IC4.70 (~TEST1), IC4.71 (~TEST2), IC4.81 (Vcc), IC4.100 (Vcc), IC4.120 (Vcc), IC6.11 (VCC), IC7.26 (CE2), IC7.28 (VCC), IC11.23 (Vcc), IC12.12 (Vcc), IC17.3 (OUT), JP2.2 (B), JP4.2 (B), L2.1, NT101.1, R1.1, R3.1, R59.1, R67.2, R77.1, R78.1, R79.1, R80.1, R81.1, R82.1, R83.1, R84.1
VDDA: C17.1, C23.1, C60.1, C69.2, IC8.94 (AYS), IC11.22 (AVcc), IC14.8 (V+), L2.2
VDDF: C16.1, C24.1, IC8.30 (AVC), IC13.12 (Vcc1), IC13.19 (Vcc2), L6.1, NT101.2, R55.1, R56.1, R57.1
