RGBeter/MegaDrive_VA6.8/MegaDrive.kicad_pcb

## KiCad design MegaDrive.kicad_pcb (continued)

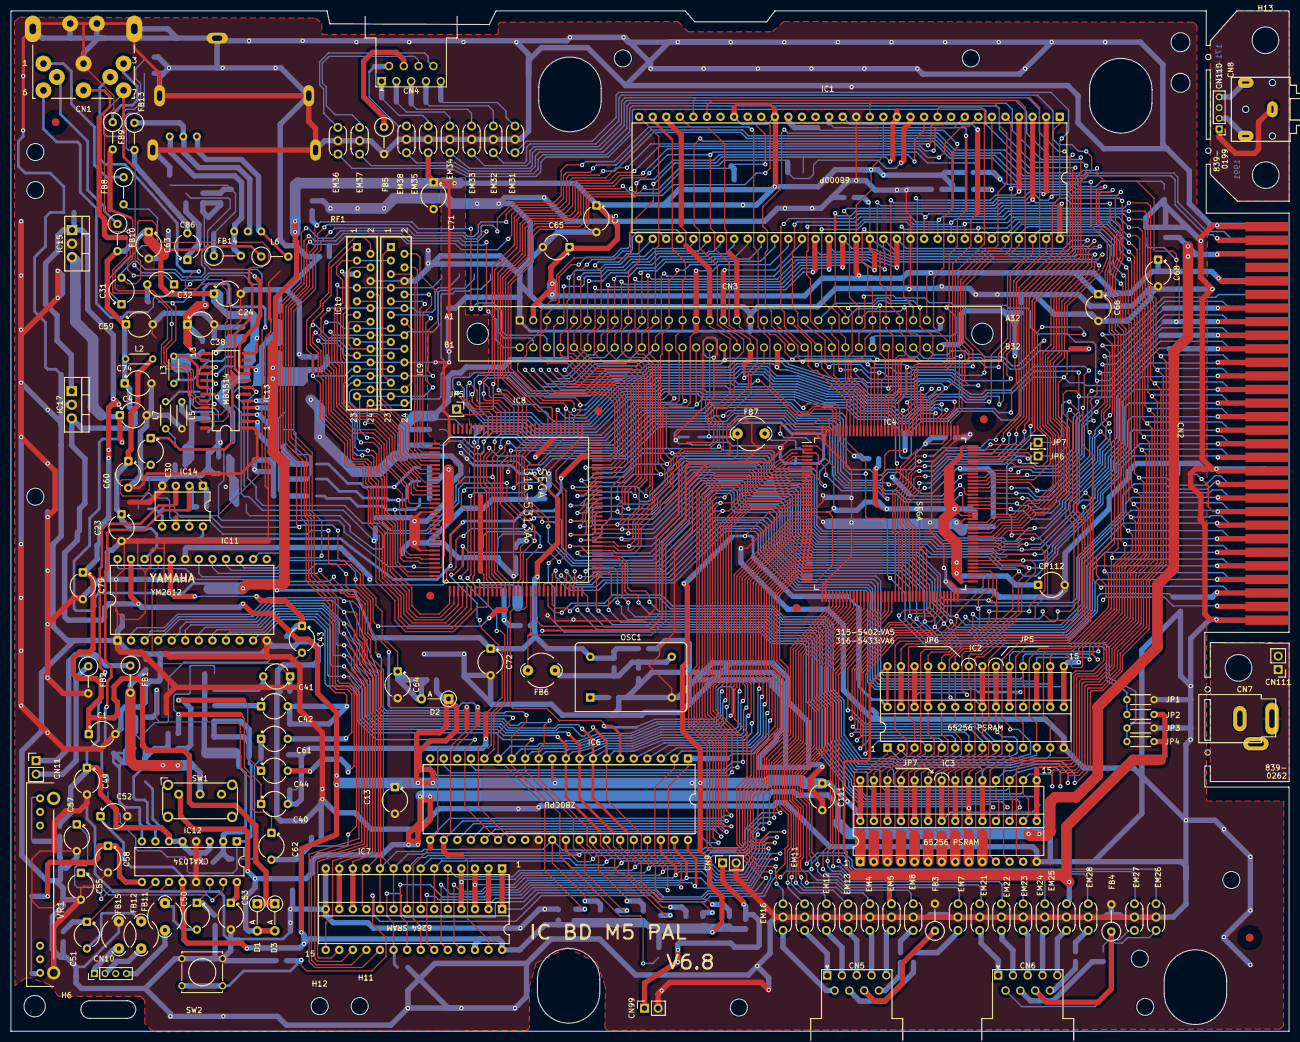
[picture p7: board MegaDrive.kicad_pcb from above]

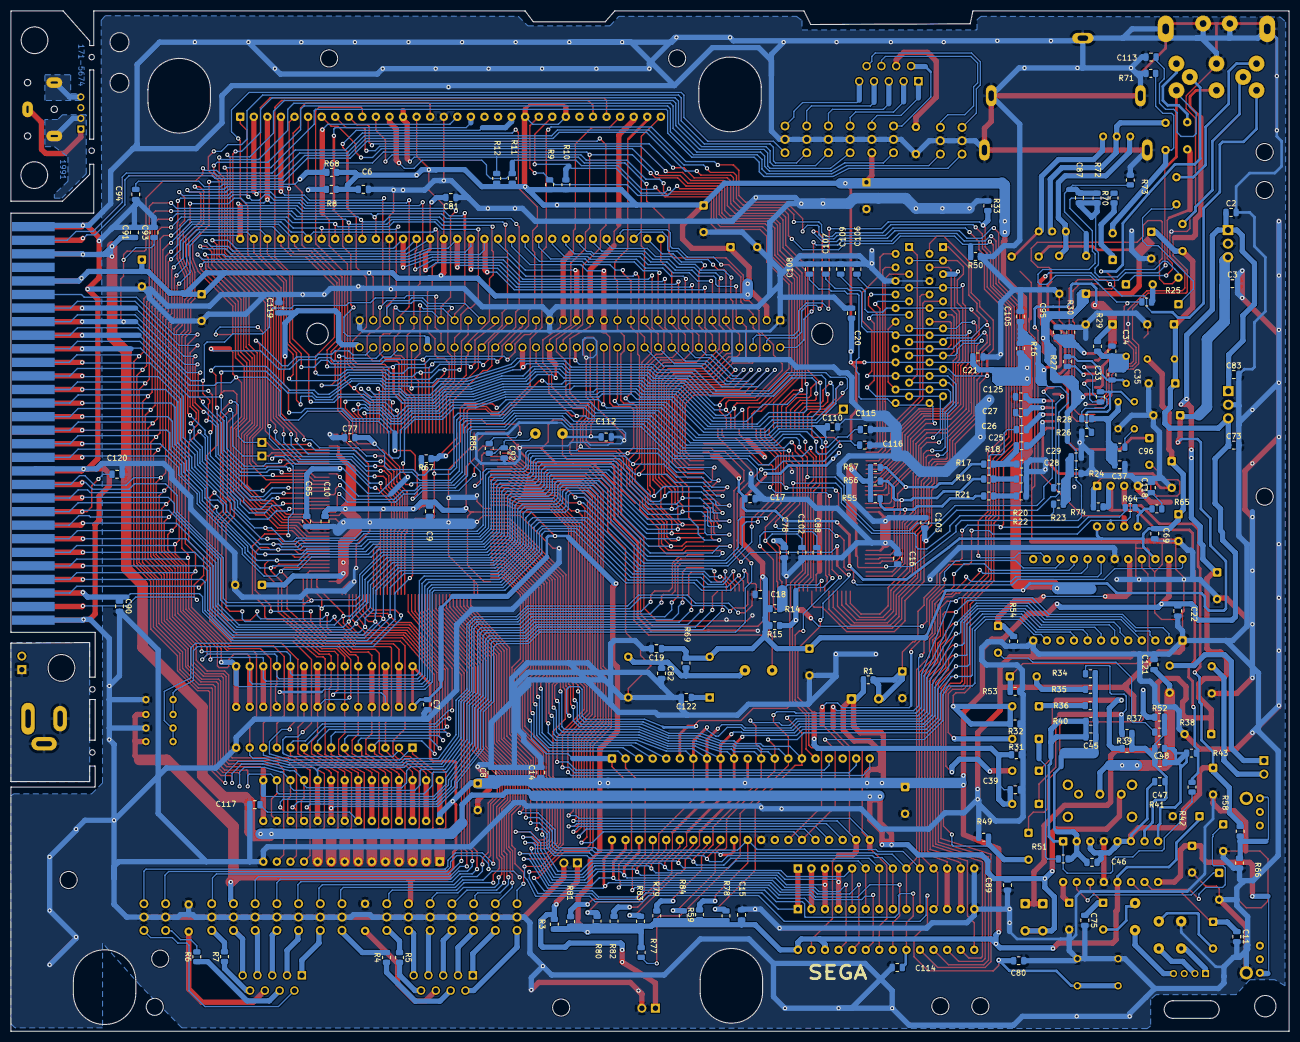
[picture p8: board MegaDrive.kicad_pcb from below]

Board: 2 copper layers, 239.3 x 191.0 mm, 292 parts (144 on the bottom side), 299 nets.
